danny-dirksen/cannulation-project/poster.pptx

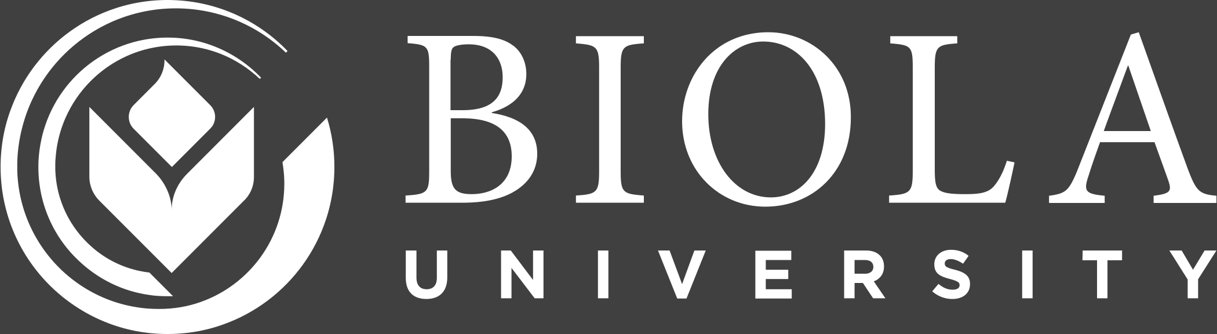
[picture p13: figure]

Automated Cannulation
Daniel Dirksen
Biola University | School of Science, Technology, and Health | SEI 2021

July 8th, 2021

Conclusions

Body Text

Abstract

Cannulation is the
Problem with previous work
Solution
Description and Details

Background

Body Text

System Overview

Body Text

Prebuilt Chamber

Explanation of how each solenoid valve works

Full Design Process

Body Text

Tubing Setup

Explanation of how each solenoid valve works

Objectives

Body Text

Simplified of arrangement of solenoid valves, + photo of setup

Single Test Timeline

Body Text

Arduino Setup

References

Body Text

Materials

Body Text

Interface description

Interface

Acknowledgements

Body Text
