danny-dirksen/cannulation-project/images/project-process-uncropped.png

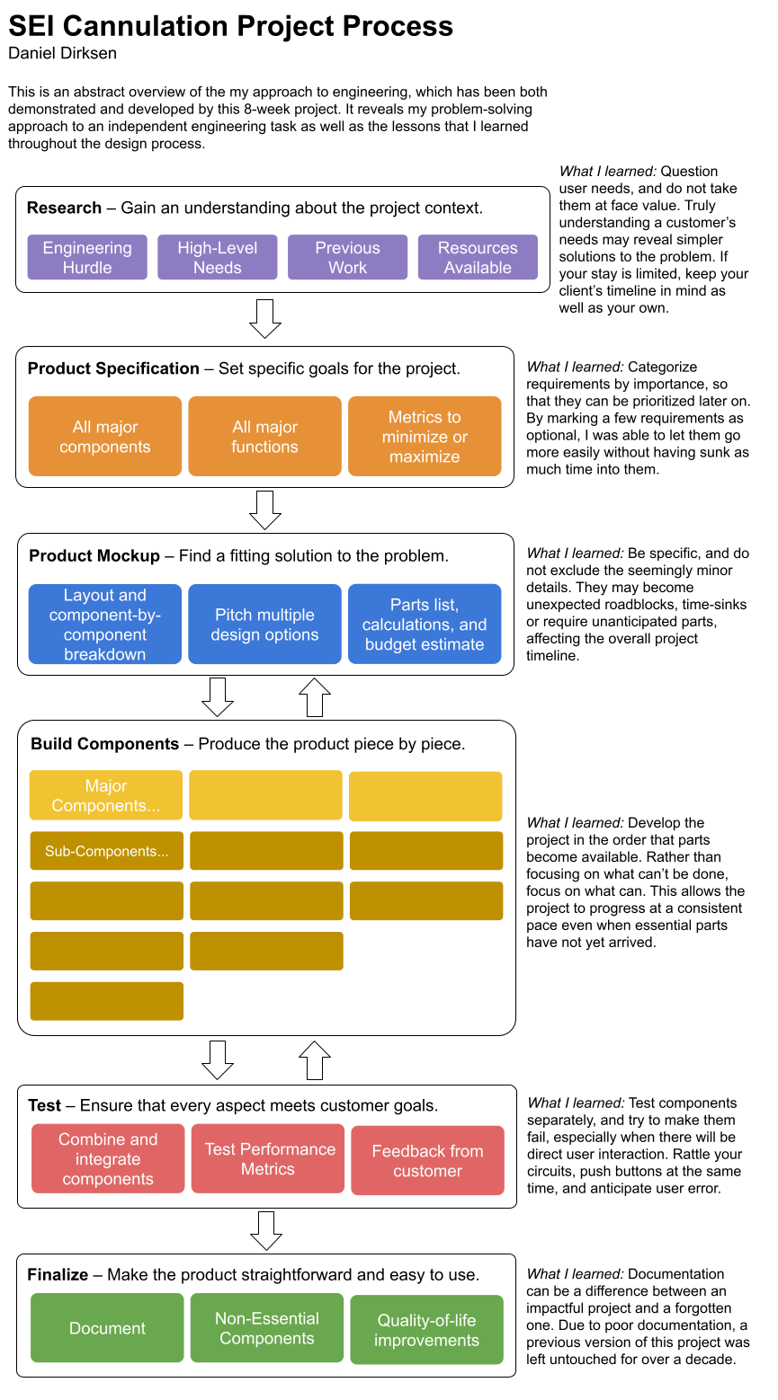
images/project-process-uncropped.png
