danny-dirksen/cannulation-project/(commit log)

2021-06-29 Inital commit
    [SEI Hours.xlsx]
2021-09-28 Added new tutorial content to readme.md
    [SEI Hours.xlsx]
